BenRover-24/docs/electronics/camera-feed.mdx

---
title: 'Configuring the Raspberry Pi with USB Camera'
description: 'A step-by-step guide to set up a USB camera on Raspberry Pi using the motion package'
---

## Configuring the Raspberry Pi with the USB camera

<Steps>
  <Step title="Install motion package">
    Run the following command:
    ```bash
    sudo apt-get install motion
    ```
  </Step>

  <Step title="Check motion service status">
    Execute the command:
    ```bash
    sudo service motion status
    ```
  </Step>

  <Step title="Create required directories">
    If you encounter an error about missing Motion folders, create them:
    ```bash
    sudo mkdir /var/log/motion
    sudo mkdir /var/lib/motion
    ```
    Verify the folders were created:
    ```bash
    ls -ld /var/log/motion
    ls -ld /var/lib/motion
    ```
  </Step>

  <Step title="Set permissions">
    Grant necessary permissions:
    ```bash
    sudo chmod -R 777 /var/log/motion
    sudo chmod -R 777 /var/lib/motion
    ```
  </Step>

  <Step title="Recheck motion service status">
    Run the command again:
    ```bash
    sudo service motion status
    ```
    If you still encounter an "access denied" error, repeat the chmod commands from Step 4.
  </Step>

  <Step title="Backup and edit motion configuration">
    Make a backup of the configuration file:
    ```bash
    sudo cp /etc/motion/motion.conf /etc/motion/motion.conf.bckp
    ```
    Edit the configuration file:
    ```bash
    sudo nano /etc/motion/motion.conf
    ```
  </Step>

  <Step title="Start motion service">
    Start the service and check its status:
    ```bash
    sudo service motion start
    sudo service motion status
    ```
  </Step>

  <Step title="Edit motion log (if enabled)">
    If enabled, edit the motion log:
    ```bash
    sudo nano ~/.motion/motion.log
    ```
    Modify the following parameters:
    <Table>
      <TableHead>
        <TableRow>
          <TableHeaderCell>Parameter</TableHeaderCell>
          <TableHeaderCell>Value</TableHeaderCell>
        </TableRow>
      </TableHead>
      <TableBody>
        <TableRow>
          <TableCell>webcontrol_port</TableCell>
          <TableCell>8080</TableCell>
        </TableRow>
        <TableRow>
          <TableCell>webcontrol_localhost</TableCell>
          <TableCell>on</TableCell>
        </TableRow>
        <TableRow>
          <TableCell>stream_port</TableCell>
          <TableCell>8081</TableCell>
        </TableRow>
        <TableRow>
          <TableCell>stream_localhost</TableCell>
          <TableCell>off</TableCell>
        </TableRow>
        <TableRow>
          <TableCell>output_movie</TableCell>
          <TableCell>on</TableCell>
        </TableRow>
        <TableRow>
          <TableCell>stream_quality</TableCell>
          <TableCell>100</TableCell>
        </TableRow>
        <TableRow>
          <TableCell>Width</TableCell>
          <TableCell>1280</TableCell>
        </TableRow>
        <TableRow>
          <TableCell>Height</TableCell>
          <TableCell>720</TableCell>
        </TableRow>
      </TableBody>
    </Table>
  </Step>
</Steps>

## Camera Feed Examples

<CardGroup cols={3}>
  <Card title="Camera Setup">
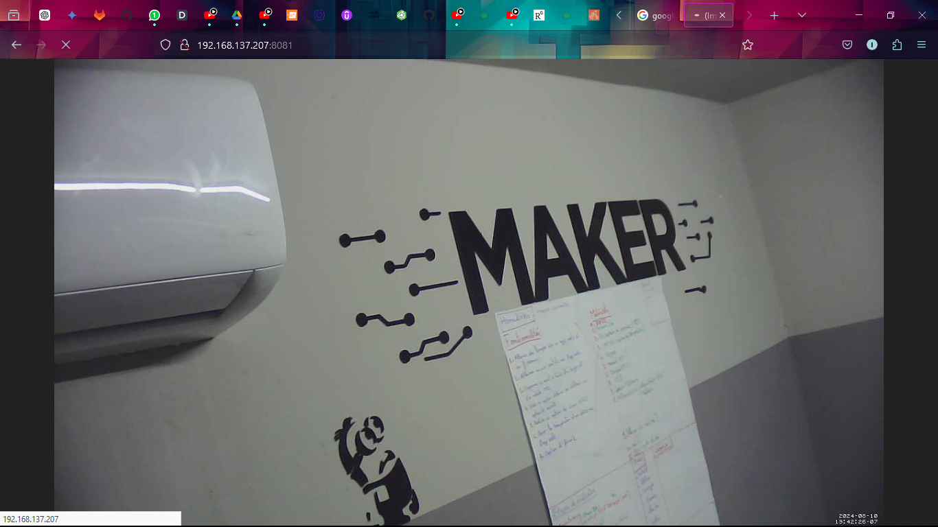
[picture p5: docs/electronics/images/cam.png]
    
  </Card>
  <Card title="Live Feed 1">
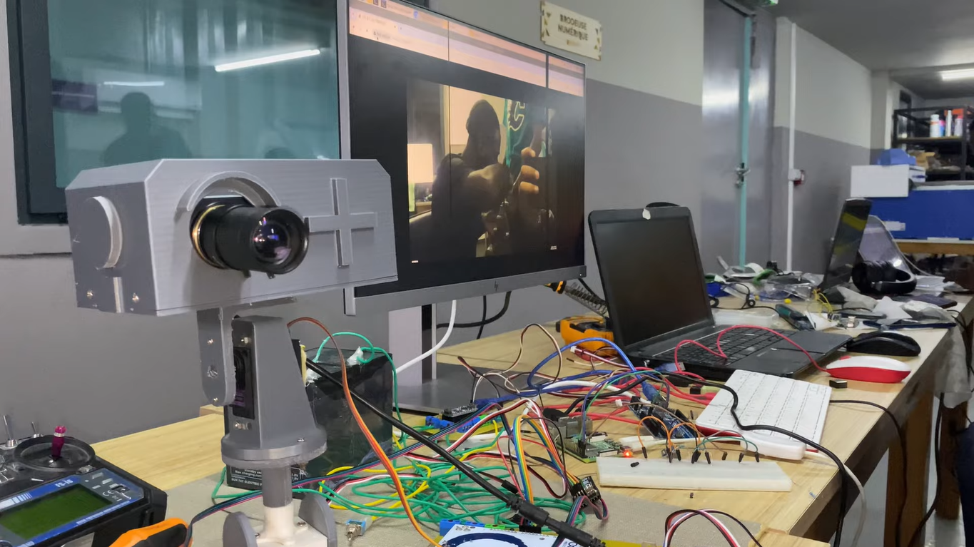
[picture p6: docs/electronics/images/live1.png]
Live feed from camera
    
  </Card>
  <Card title="Live Feed 2">
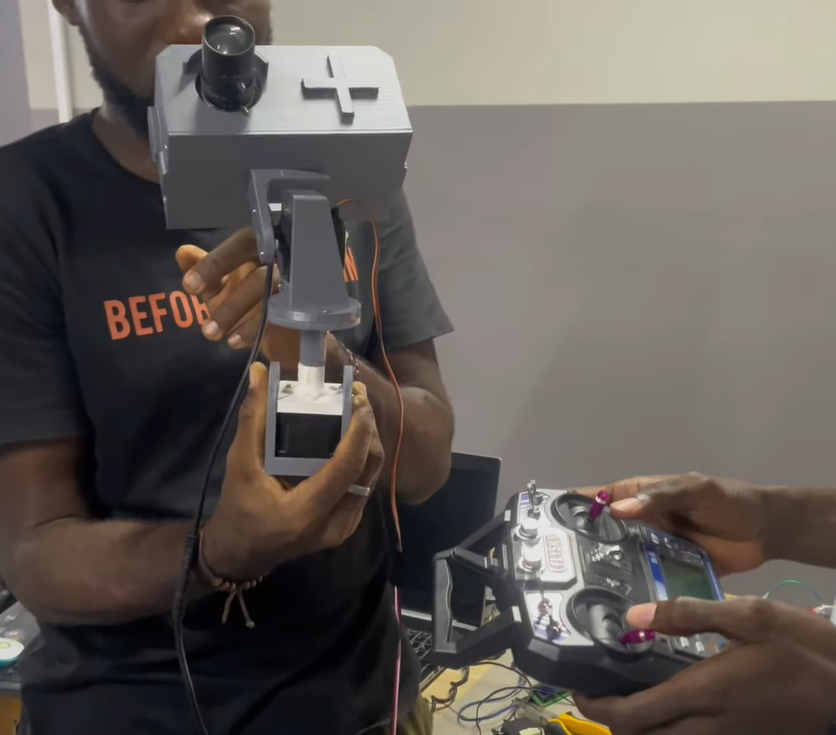
[picture p7: docs/electronics/images/live2.png]
Live feed from camera
    
  </Card>
</CardGroup>
