BenRover-24/docs/design/logo.mdx

---
title: 'Logo Design'
description: "Take a look at the design concepts behind the BenRover logo."
---

## Concepts

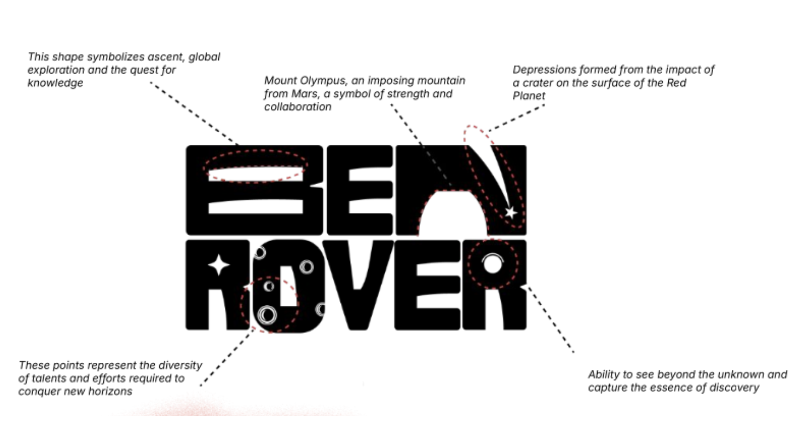
[picture p13: design/images/benrover_logo_concepts.png]
BenRover Logo Concepts


## Assets and Colors

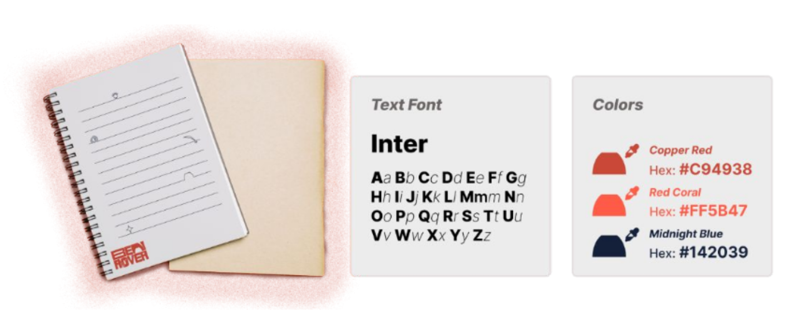
[picture p14: design/images/benrover_colors.png]
BenRover Logo Colors
