BenRover-24/docs/design/skin.mdx

---
title: 'Skin Design'
description: "Take a look at the design concepts behind the BenRover skin."
---

## Concepts

<Note>
We wanted our rover to look
like Hèviosso, the voodoo god of thunder in Beninese culture.
</Note>

So we created a skin for it to wear when it wants to be Hèviosso.
This skin takes all the main attributes associate to this divinity in
myths and legends.

<CardGroup cols={3}>
  <Card title="Ebony black body">
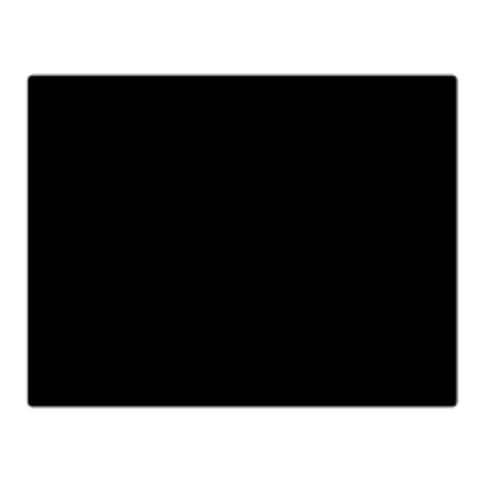
[picture p15: design/images/skins/ebony_black.png]
Ebony black body
    
  </Card>
  <Card title="Truncated and deformed face">
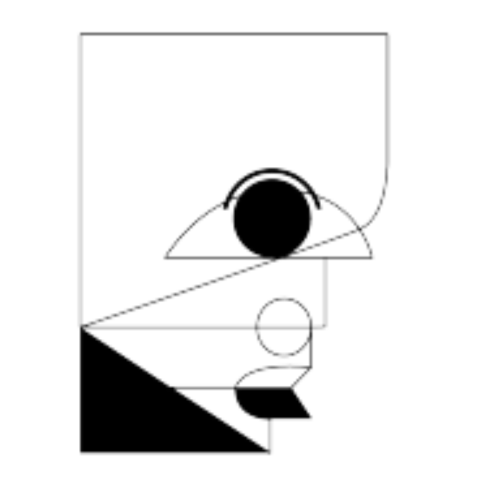
[picture p16: design/images/skins/face.png]
Truncated and deformed face
    
  </Card>
  <Card title="Double-edged battle-axe in hand">
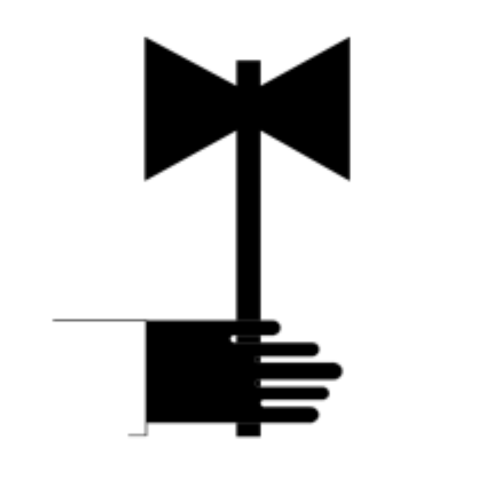
[picture p17: design/images/skins/axe.png]
Double-edged battle-axe in hand
    
  </Card>
  <Card title="Thunder he master">
    Thunder he master
  </Card>
  <Card title="Belier and Faisan as totem animals">
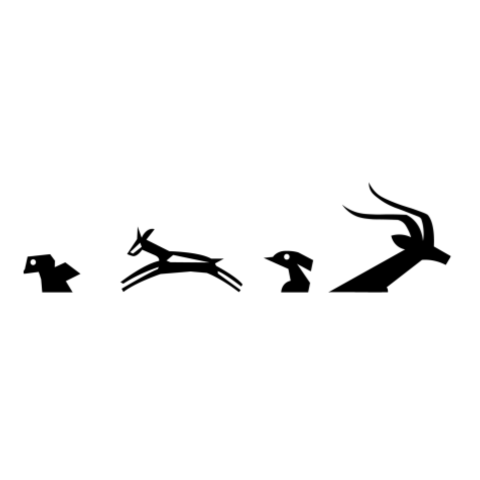
[picture p18: design/images/skins/animals.png]
Belier and Faisan as totem animals
    
  </Card>
  <Card title="Red ceremonial skirt, adorned with cowrie shells">
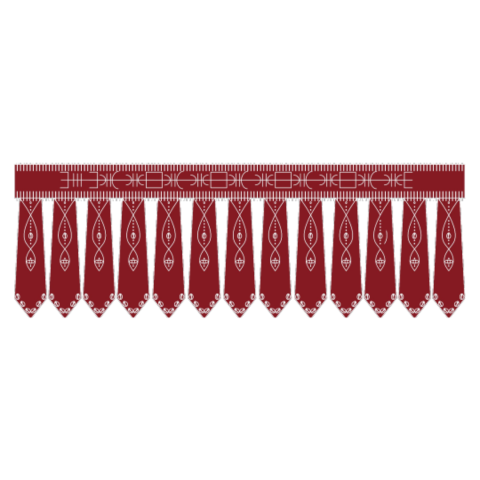
[picture p19: design/images/skins/skirts.png]
Red ceremonial skirt, adorned with cowrie shells
    
  </Card>

</CardGroup>

---

## The skin

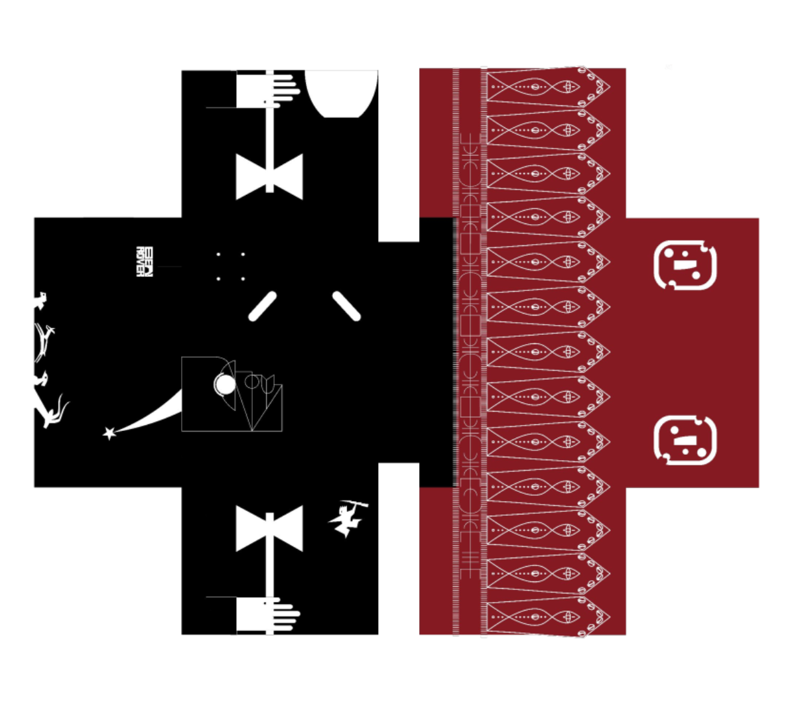
[picture p20: design/images/skins/the_skin.png]
The Skin
