BenRover-24/docs/design/images/skins/thunder.png

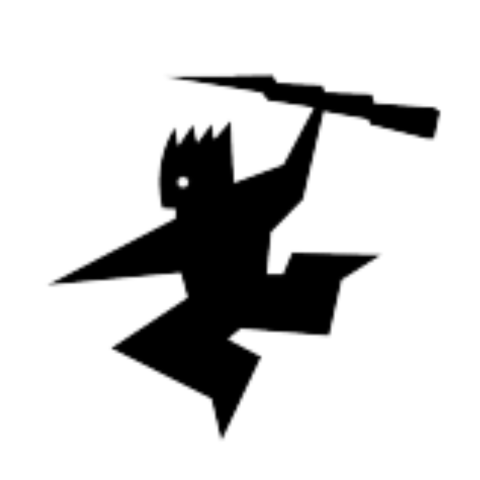
design/images/skins/thunder.png
