BenRover-24/docs/electronics/software-materials.mdx

---
title: Software and Materials
description: 'An overview of the software and materials used in the BenRover project'
---

## Software 💻

### Arduino IDE
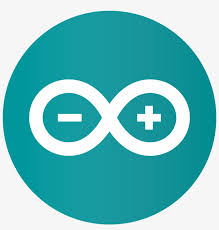
[picture p22: docs/electronics/images/software/IDE arduino.jpeg]
Arduino IDE


Using the Arduino IDE made programming the Arduino Mega easier.

### KiCad
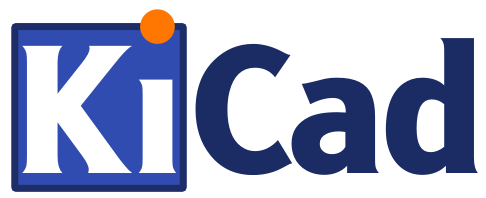
[picture p23: docs/electronics/images/software/Kicad_logo_new.png]
KiCad


The entry of the electrical diagram and the creation of the printed circuit were carried out on KiCad, which is a suite of free software for drawing electronic diagrams and designing printed circuits, offering a 3D visualization of our PCB and other tools necessary for the design of electronic circuits.

### FlatCAM
FlatCAM

Flatcam is a software for generating the CNC jobs G-codes.

### Candle
Candle

Candle is a software for controlling the CNC machine.

### Fritzing
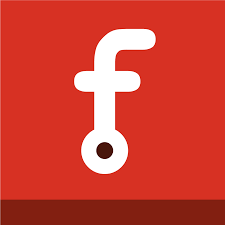
[picture p24: docs/electronics/images/software/fritzing.png]
Fritzing


Using Fritzing, an electronic circuit design software, allowed us to create an overview of the different connections between the project components.

## Materials 🛠️

<CardGroup cols={3}>
  <Card title="Arduino MEGA" icon="microchip">
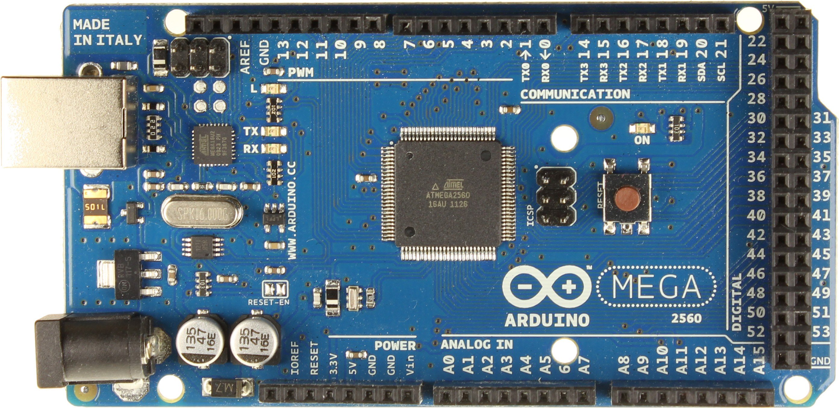
[picture p25: docs/electronics/images/materials/arduinomega.jpg]
Arduino MEGA
    
    Quantity: 01
    
    [Buy on YoupiLab](https://youpilab.com/components/product/arduino-mega-2560)
  </Card>
  <Card title="Arduino NANO" icon="microchip">
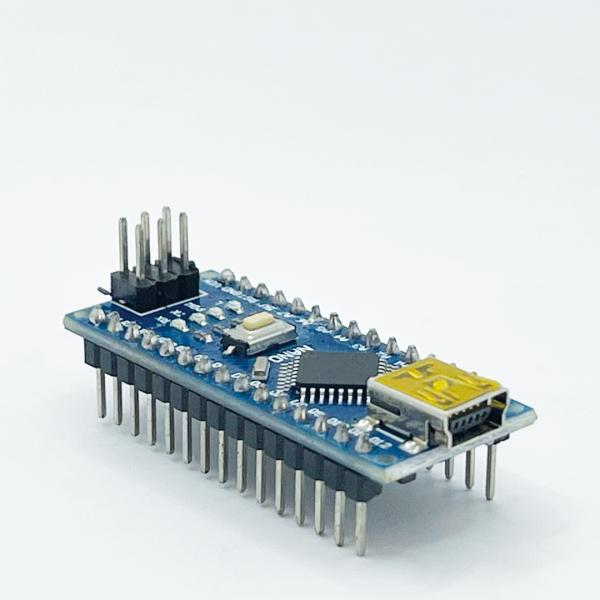
[picture p26: docs/electronics/images/materials/arduino_nano.jpg]
Arduino NANO
    
    Quantity: 01
    
    [Buy on YoupiLab](https://youpilab.com/components/product/arduino-nano-ch340)
  </Card>
  <Card title="Raspberry Pi 4 Model B" icon="raspberry-pi">
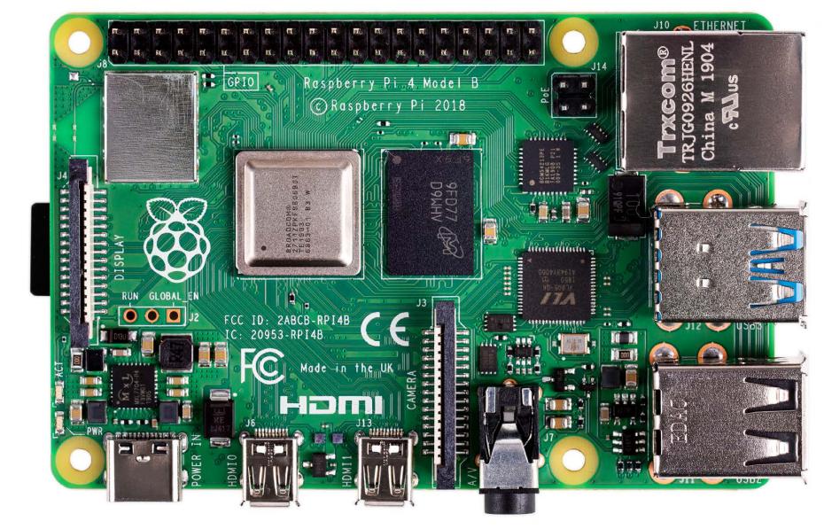
[picture p27: docs/electronics/images/materials/raspberry.jpg]
Raspberry Pi 4
    
    Quantity: 02
    
    [Buy on YoupiLab](https://youpilab.com/components/product/raspberry-pi4-model-ram-8giga)
  </Card>
</CardGroup>

<CardGroup cols={3}>
  <Card title="Servo-motor REV-41-1097" icon="cog">
    Servo-motor
    Quantity: 05
    
    [Buy on REV Robotics](https://www.revrobotics.com/rev-41-1097/)
  </Card>
  <Card title="Stepper Motor" icon="cog">
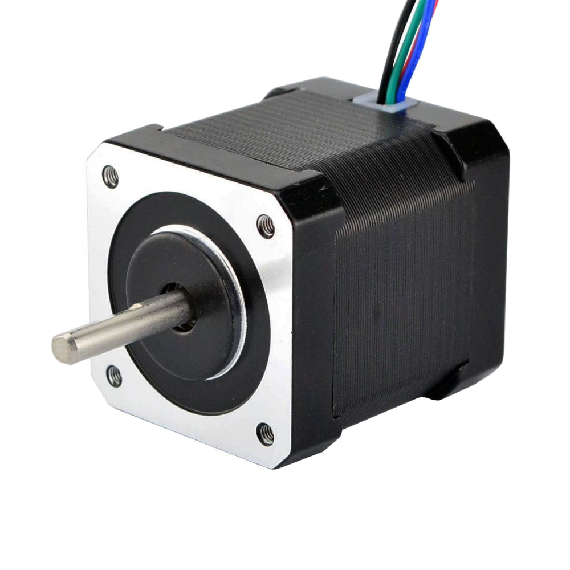
[picture p28: docs/electronics/images/materials/Moteur_pas_à_pas_Nema_17.png]
Stepper Motor
    
    Quantity: 01
    
    [Buy on YoupiLab](https://youpilab.com/components/product/moteur-pas-a-pas-nema-17-42hs48)
  </Card>
  <Card title="Continuous Motor (XD37GB-555YSY 50rpm)" icon="cog">
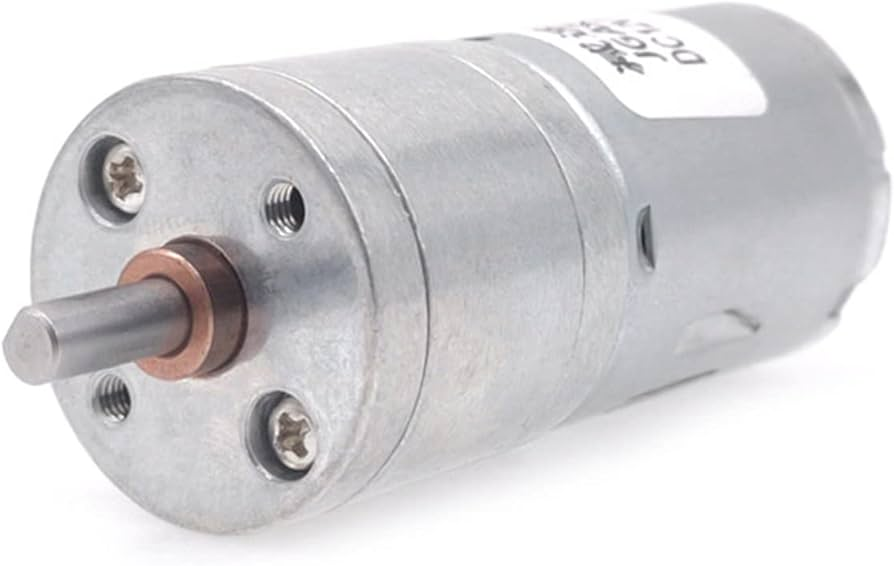
[picture p29: docs/electronics/images/materials/motor.jpg]
Continuous Motor
    
    Quantity: 06
    
    [Buy on YoupiLab](https://youpilab.com)
  </Card>
</CardGroup>

<CardGroup cols={3}>
  <Card title="Camera" icon="camera">
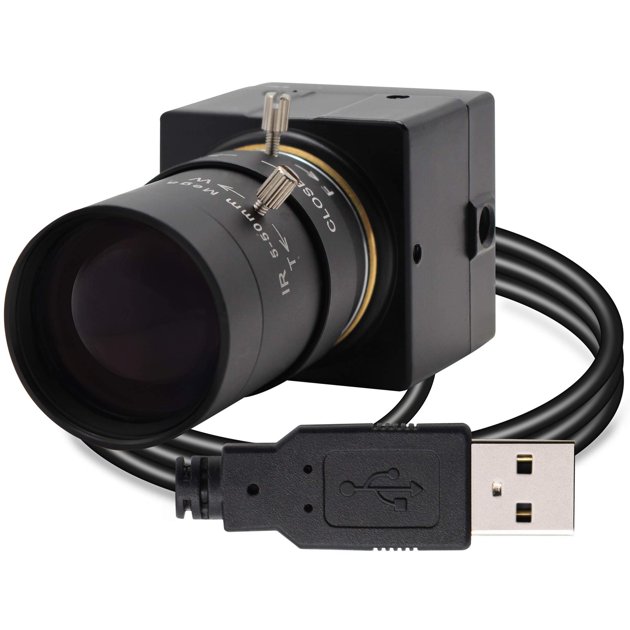
[picture p30: docs/electronics/images/materials/camera.jpg]
Camera
    
    Quantity: 01
    
    [Buy on YoupiLab](https://youpilab.com)
  </Card>
  <Card title="Flysky FS-i6 RC" icon="radio">
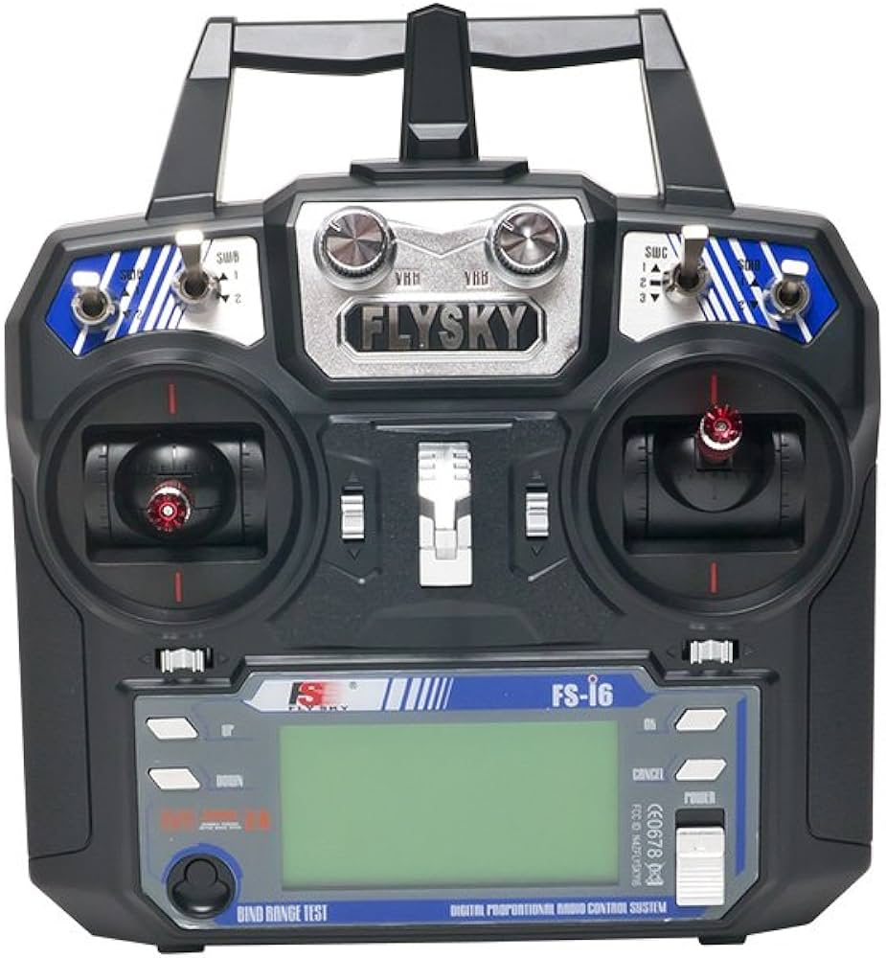
[picture p31: docs/electronics/images/materials/flysky_tx.jpg]
Flysky FS-i6 RC
    
    Quantity: 01
  </Card>
  <Card title="Flysky FS-iA6 (receiver)" icon="radio">
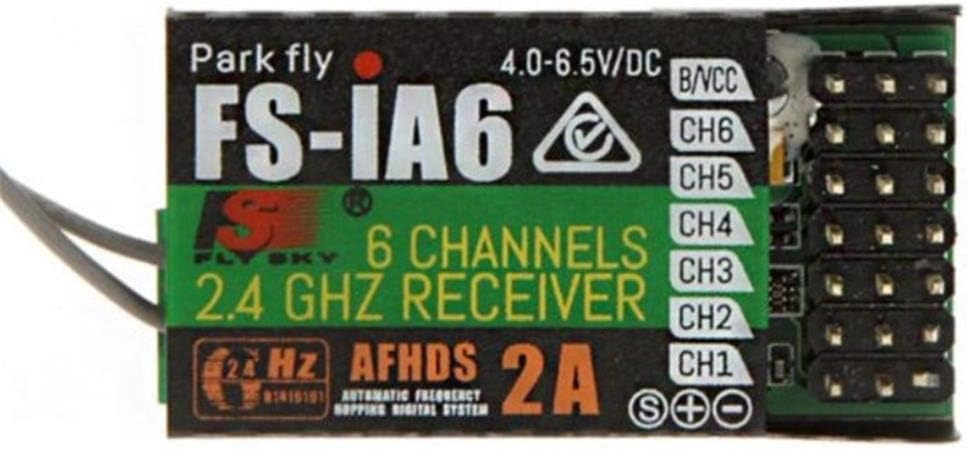
[picture p32: docs/electronics/images/materials/receiver_flysky.jpg]
Flysky FS-iA6 (receiver)
    
    Quantity: 01
  </Card>
</CardGroup>

<CardGroup cols={3}>
  <Card title="A4988 stepper motor driver" icon="microchip">
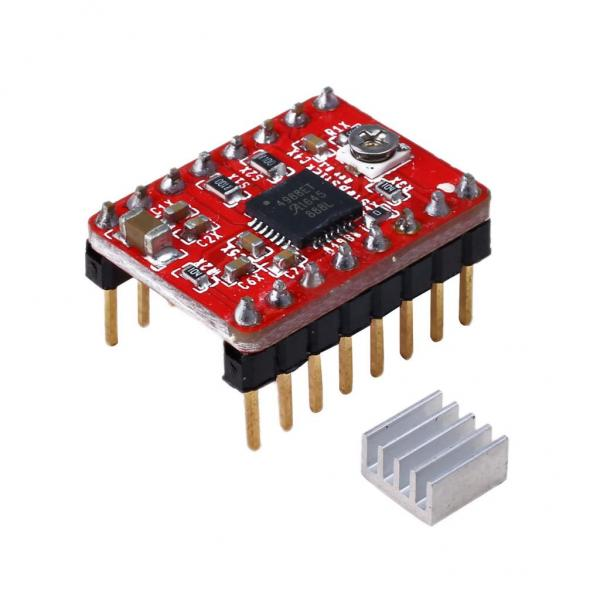
[picture p33: docs/electronics/images/materials/A4988_Stepper_Motor_Driver.jpeg]
A4988
    
    Quantity: 01
    
    [Buy on YoupiLab](https://youpilab.com/components/product/a4988-stepper-motor-driver)
  </Card>
  <Card title="TIP 122" icon="microchip">
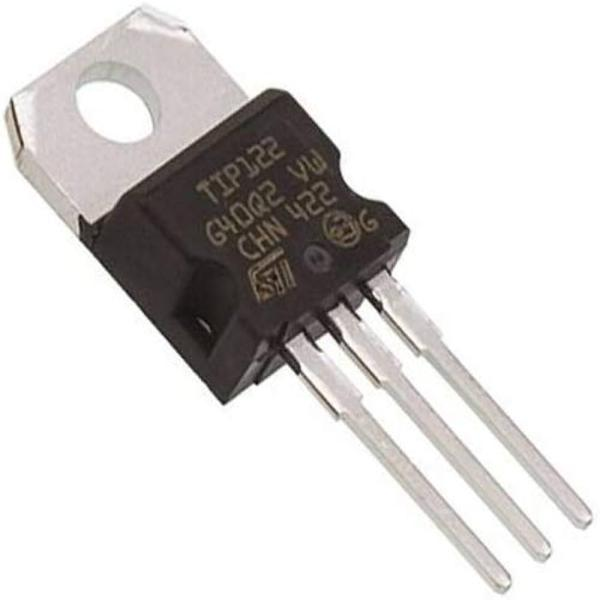
[picture p34: docs/electronics/images/materials/TIP122.jpg]
TIP 122
    
    Quantity: 06
    
    [Buy on YoupiLab](https://youpilab.com/components/product/transistor-darlington-tip122)
  </Card>
  <Card title="Terminal block" icon="plug">
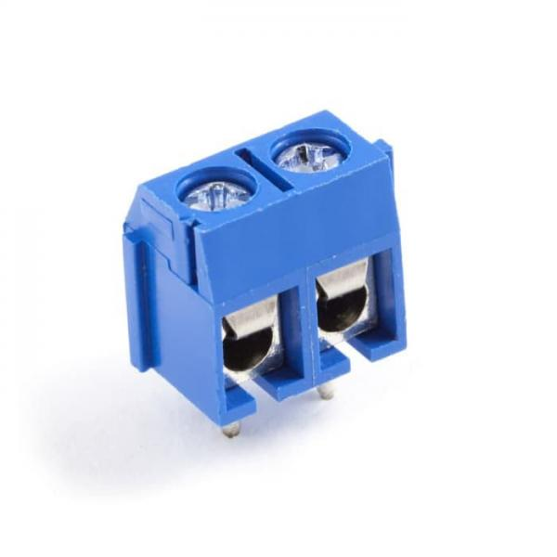
[picture p35: docs/electronics/images/materials/T-block.jpg]
Terminal block
    
    Quantity: 30
    
    [Buy on YoupiLab](https://youpilab.com/components/product/bornier-2-broches)
  </Card>
</CardGroup>

<CardGroup cols={3}>
  <Card title="Header pin male" icon="plug">
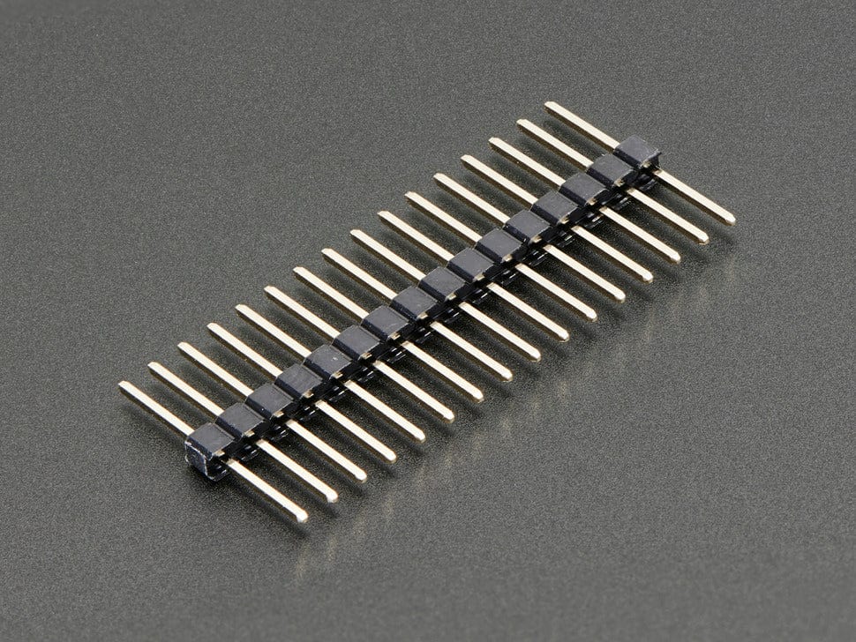
[picture p36: docs/electronics/images/materials/header_pin_mal.jpg]
Header pin male
    
    Quantity: 30
    
    [Buy on YoupiLab](https://youpilab.com)
  </Card>
  <Card title="Header pin female" icon="plug">
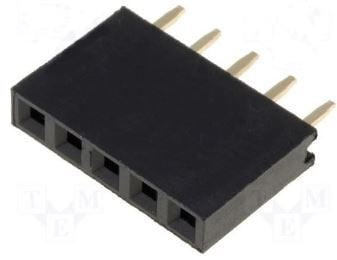
[picture p37: docs/electronics/images/materials/header_pin_femel.jpg]
Header pin female
    
    Quantity: 30
    
    [Buy on YoupiLab](https://youpilab.com)
  </Card>
  <Card title="Flexible Heat Resistant Electrical Wire" icon="bolt">
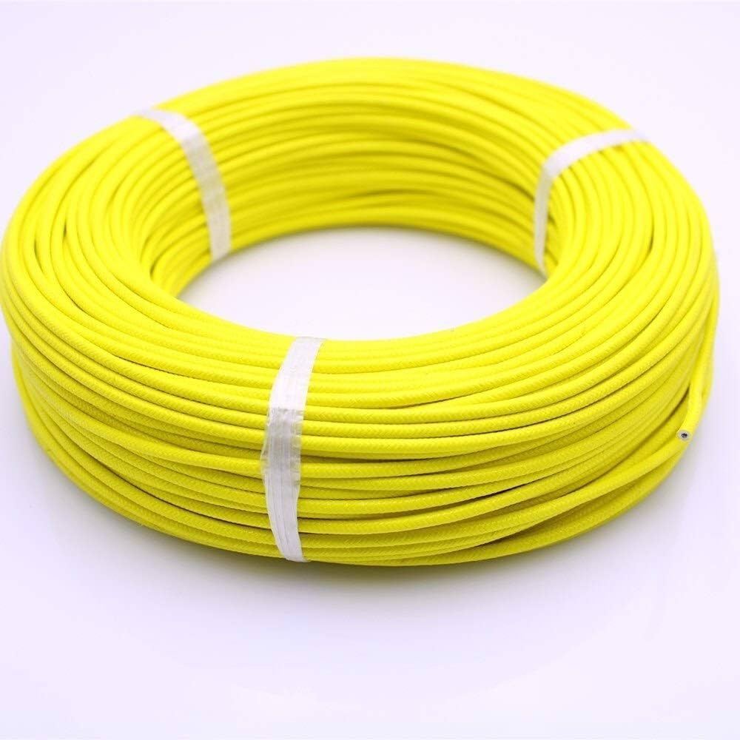
[picture p38: docs/electronics/images/materials/Fil_électrique_résistant_à_la_chaleur.jpg]
Flexible Heat Resistant Electrical Wire
    
    Quantity: 06
    
    [Buy on YoupiLab](https://youpilab.com/components/product/fil-electrique-resistant-a-la-chaleur-jaune-metre)
  </Card>
</CardGroup>

<CardGroup cols={3}>
  <Card title="Grove wire (3 and 4 pins) 1 m" icon="plug">
    Grove wire
    Quantity: 10
  </Card>
  <Card title="Power Supply" icon="battery-full">
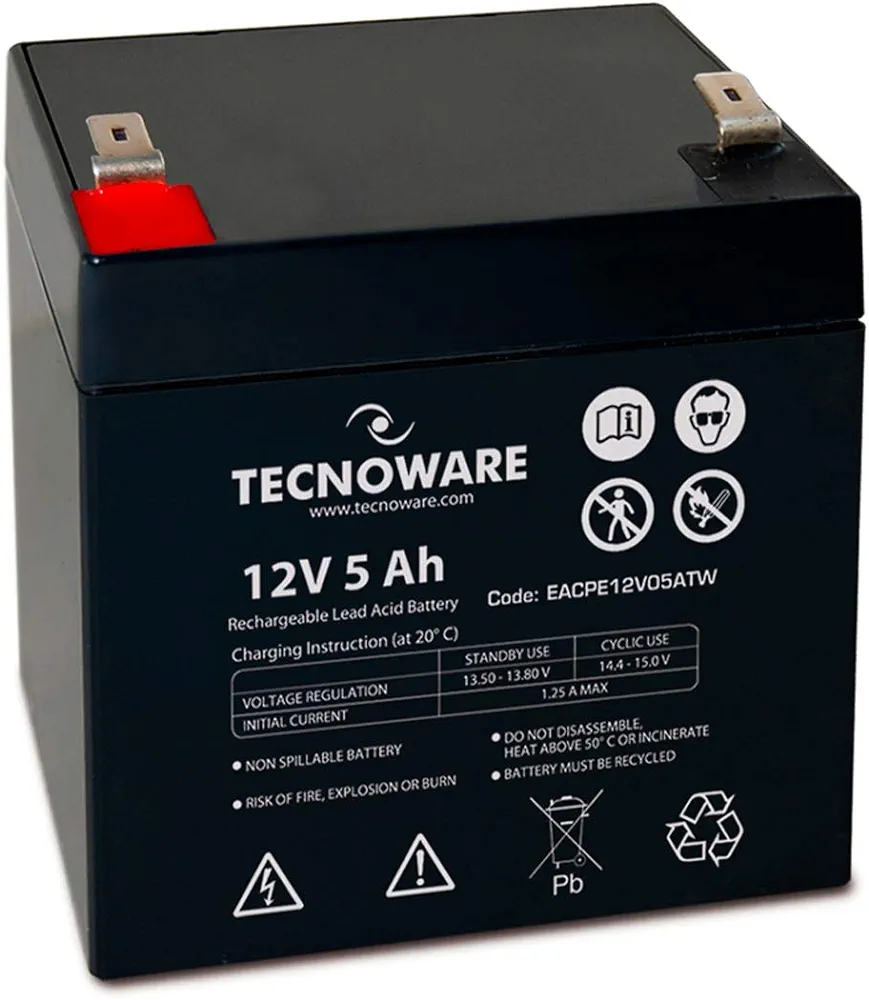
[picture p39: docs/electronics/images/materials/batterie_de_moto.jpg]
Power Supply
    
    Quantity: 06
  </Card>
  <Card title="LCD screen + i2c module" icon="tv">
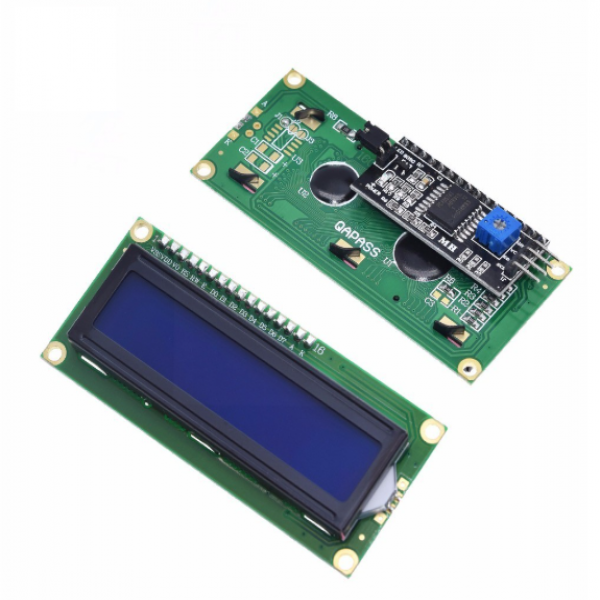
[picture p40: docs/electronics/images/materials/lcd_modul_i2c.png]
LCD screen + i2c module
    
    Quantity: 02
    
    [Buy on YoupiLab](https://youpilab.com/components/product/ecran-lcd-16x02-avec-iLink2c)
  </Card>
</CardGroup>

<CardGroup cols={3}>
  <Card title="LM35 temperature sensor" icon="thermometer">
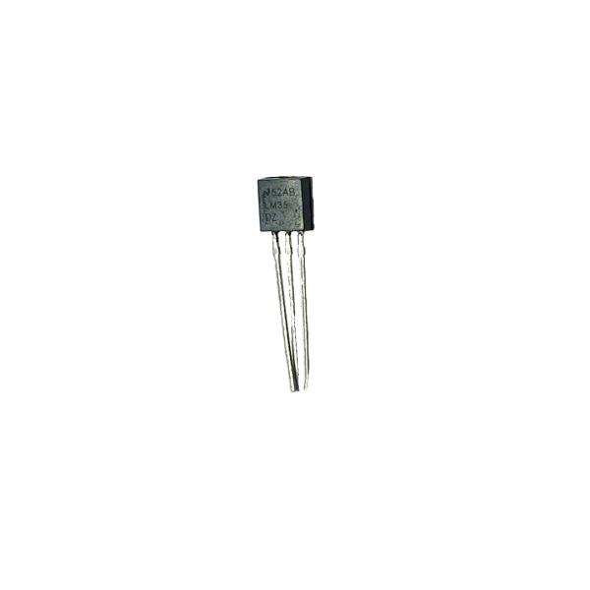
[picture p41: docs/electronics/images/materials/lm35.jpg]
LM35 temperature sensor
    
    Quantity: 02
    
    [Buy on YoupiLab](https://youpilab.com/components/product/capteur-de-temperature-lm35dz)
  </Card>
  <Card title="MPU6050" icon="microchip">
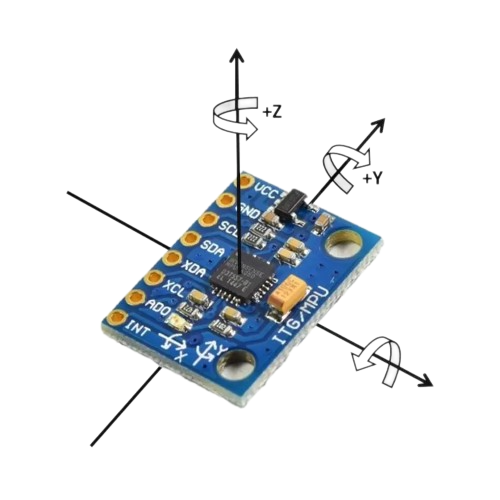
[picture p42: docs/electronics/images/materials/mpu.png]
MPU6050 sensor
    
    Quantity: 02
  </Card>
  <Card title="Copper plate for PCB" icon="square">
    Copper plate for PCB
    Quantity: 04
  </Card>
</CardGroup>
