BenRover-24/docs/(commit log)

2024-07-19 Bump mkdocs-material from 9.5.28 to 9.5.29
    Bumps [mkdocs-material](https://github.com/squidfunk/mkdocs-material) from 9.5.28 to 9.5.29.
    - [Release notes](https://github.com/squidfunk/mkdocs-material/releases)
    - [Changelog](https://github.com/squidfunk/mkdocs-material/blob/master/CHANGELOG)
    - [Commits](https://github.com/squidfunk/mkdocs-material/compare/9.5.28...9.5.29)
    ---
    updated-dependencies:
    - dependency-name: mkdocs-material
    dependency-type: direct:production
    update-type: version-update:semver-patch
    ...
2024-08-01 Rename A4988 Stepper Motor Driver.jpeg to A4988_Stepper_Motor_Driver.jpeg
2024-08-01 Rename Fil électrique résistant à la chaleur.jpg to Fil électrique_résistant_à_la_chaleur.jpg
2024-08-01 Rename alimentation raspberry pi sy8205.jpg to alimentation_raspberry_pi_sy8205.jpg
2024-08-01 Rename batterie de moto.jpg to batterie_de_moto.jpg
2024-08-05 Bump mkdocs-material from 9.5.29 to 9.5.31
    Bumps [mkdocs-material](https://github.com/squidfunk/mkdocs-material) from 9.5.29 to 9.5.31.
    - [Commits](https://github.com/squidfunk/mkdocs-material/compare/9.5.29...9.5.31)
    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
2024-08-07 Add files via upload
    code permettant au rover d'aborder les virage
2024-08-07 Add files via upload
    code du block de la batterie
2024-08-12 Update Ackermann Steering Geometry
2024-08-13 Create Servo motors interfacing with Arduino mega board through TIP122 transistors
2024-08-13 Update Servo motors interfacing with Arduino mega board through TIP122 transistors
2024-09-02 Bump mkdocs-material from 9.5.31 to 9.5.34
    Bumps [mkdocs-material](https://github.com/squidfunk/mkdocs-material) from 9.5.31 to 9.5.34.
    - [Commits](https://github.com/squidfunk/mkdocs-material/compare/9.5.31...9.5.34)
    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
2024-09-10 Add files via upload
    code python permettant la réception des données envoyées par le block ems par liaison i2c
2024-09-12 Rename Servo motors interfacing with Arduino mega board through TIP122 transistors to ServoMotors.md
2024-09-26 Bump mkdocs-material from 9.5.34 to 9.5.38
    Bumps [mkdocs-material](https://github.com/squidfunk/mkdocs-material) from 9.5.34 to 9.5.38.
    - [Commits](https://github.com/squidfunk/mkdocs-material/compare/9.5.34...9.5.38)
    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
2024-09-26 correction des lien de certaines images
2024-09-26 correction de certains liens d'image
2024-09-26 correction de certainsliens d'image
2024-10-12 Write ROS documentation and Update Servo motors images links
